AndreiVladescu/Smart-B.A.T.S./README.md

# Smart B.A.T.S. :
Blind Assistant Technological System
