AndreiVladescu/Smart-B.A.T.S./Modele 3D/prisma45.stl

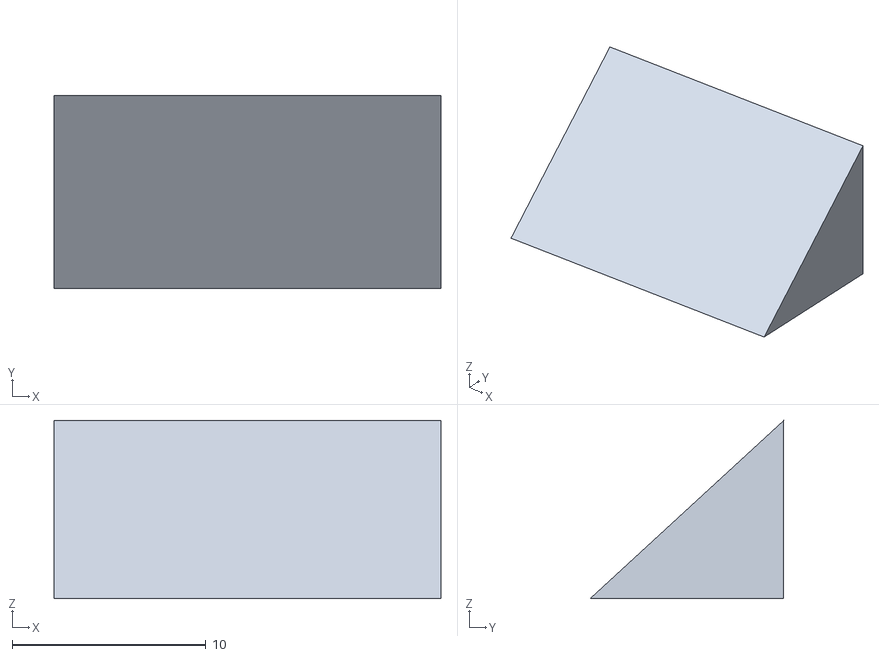
[picture p30: CAD file, 2019-07-28]
Modele 3D/prisma45.stl
20.0 x 10.0 x 9.20
