AndreiVladescu/Smart-B.A.T.S./Modele 3D/prisma.stl

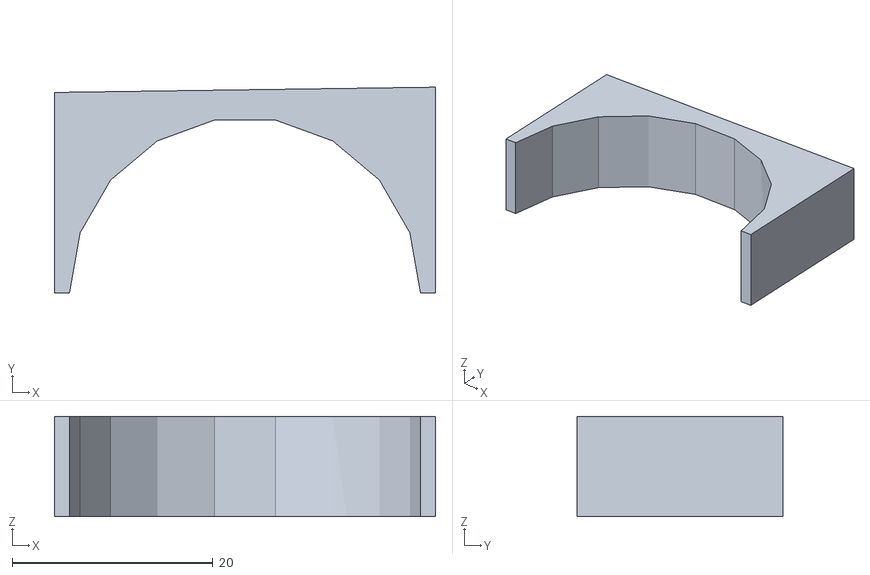
[picture p31: CAD file, 2019-07-28]
Modele 3D/prisma.stl
38.0 x 20.5 x 10.0
