AndreiVladescu/Smart-B.A.T.S./Modele 3D/enclosure.stl

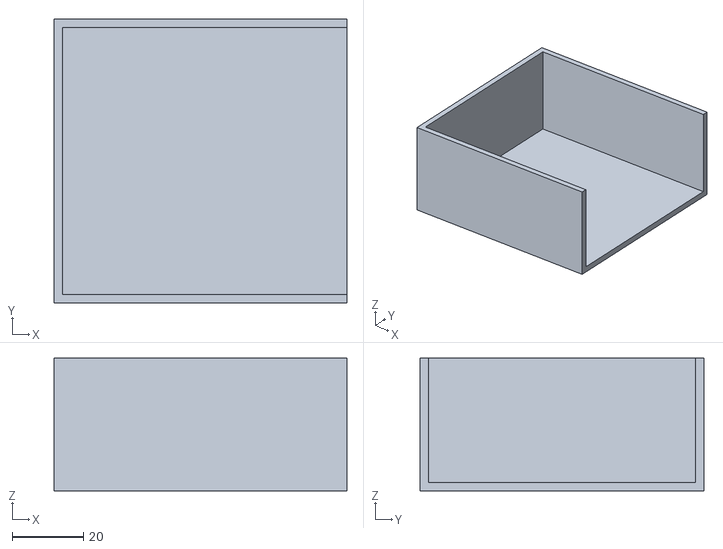
[picture p32: CAD file, 2019-07-28]
Modele 3D/enclosure.stl
82.3 x 79.7 x 37.3
