AndreiVladescu/Smart-B.A.T.S./Modele 3D/Design1.stl

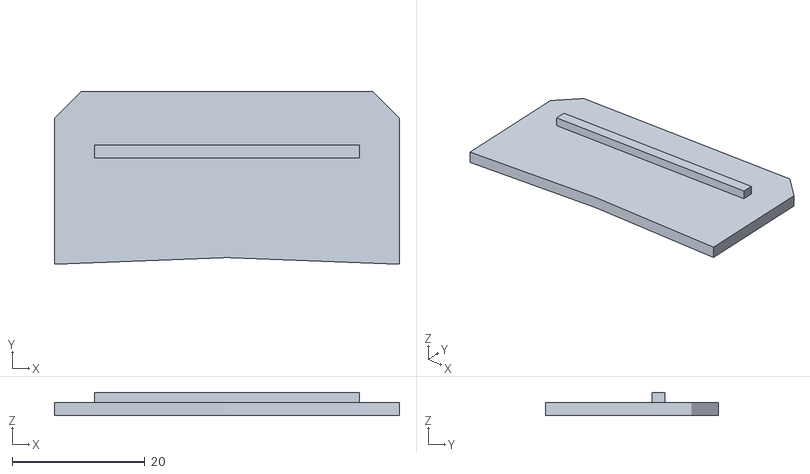
[picture p33: CAD file, 2019-07-28]
Modele 3D/Design1.stl
52.0 x 26.0 x 3.50
