AndreiVladescu/Smart-B.A.T.S./Modele 3D/suport2.stl

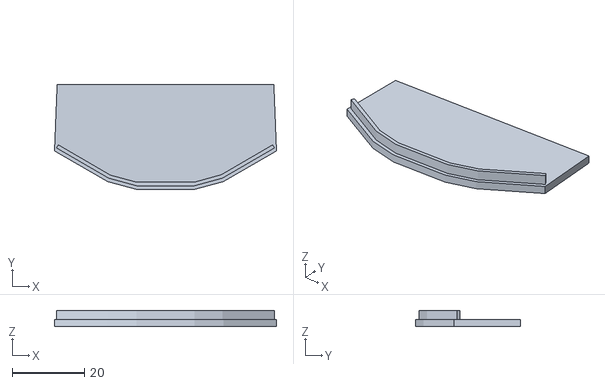
[picture p34: CAD file, 2019-07-28]
Modele 3D/suport2.stl
61.4 x 29.0 x 4.50
