AndreiVladescu/Smart-B.A.T.S./Scheme.pdf

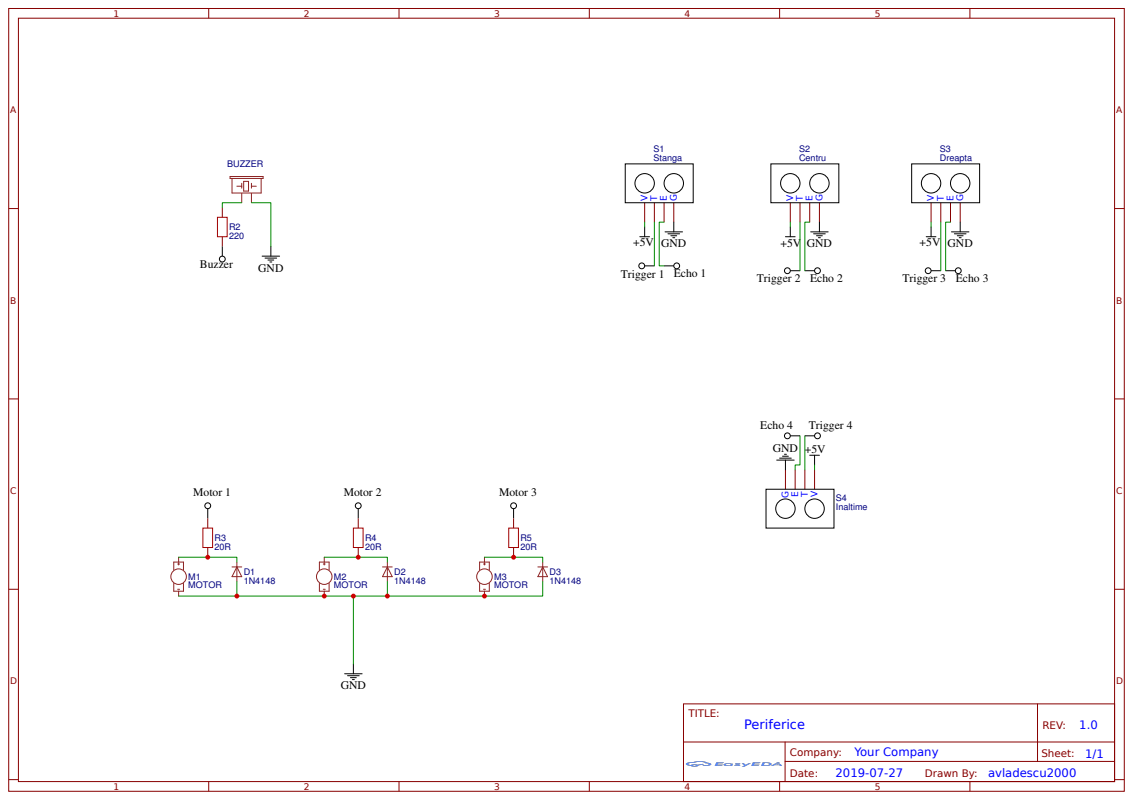
[picture p35: page 1]
TITLE:; Periferice; REV: 1.0; Date:; Sheet: 1/1 Drawn By: avladescu2000; MOTOR; BUZZER; GND; Buzzer; Motor 1; Motor 2; Motor 3; Stanga; Centru; Dreapta; Inaltime; Echo 4 Trigger 4; Trigger 1 Echo 1; Trigger 2 Echo 2; Trigger 3 Echo 3

Company: Your Company

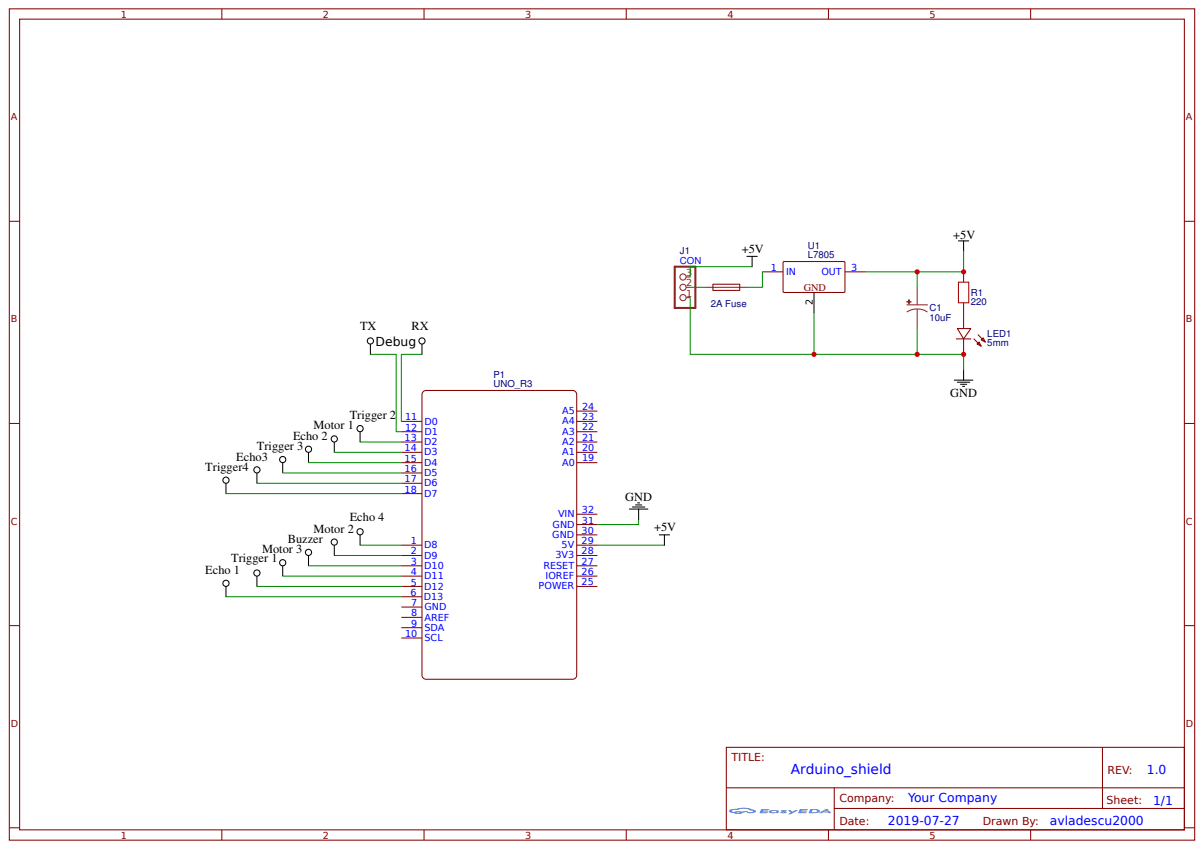
[picture p36: page 2]

POWER 25 IOREF 26 RESET 27 3V3 28 5V 29 GND 30 GND 31 VIN 32
